KP191458/Lidar2d/README.md

# Lidar2d
Hardware and software implementation of two demensional lidar.
