KP191458/Lidar2d/Thesis/02_introduction.tex

\section {Wstęp}
\subsection {Czym jest LIDAR ?}

Za wikipedią:
Lidar (od angielskiego akronimu LIDAR, utworzonego od wyrażenia: Light Detection and Ranging)
– urządzenie działające na podobnej zasadzie jak radar (Radio Detection and Ranging), ale
wykorzystujące światło lasera zamiast mikrofal. Urządzenie charakteryzuje się wysoką
rozdzielczością \cite{lidar_pl}.\\

Pierwsze użycie lasera do pomiaru odległości miało miejsce na potrzeby amerykańskiego 
wojska na początku lat 60, zaraz po wynalezieniu lasera. Było to użycie laserowego dalmierza 
model Colidar Mark II - obiekt, ze względu na swoje rozmiary, przypominał strzelbę \cite{lidar_en}.\\

Pierwsze zastosowanie urządzeń przypominających obecne Lidary to rok 1971 i działalność
Amerykańskiego Centrum Badań Fizyki Atmosfery w Boulder w Kolorado (National Center for
Atmospheric Research). Urządzenie dokonywało pomiaru wysokości chmur i zanieczyszczenia
atmosferycznego. Kolejne zastosowanie tego samego roku miało miejsce w czasie misji
Apollo 15 gdzie za pomocą sonaru laserowego (tak technologia ta była wówczas nazywana)
skanowano powierzchnię księżyca \cite{lidar_en}.\\

Ogólna zasada działania polega na połączeniu lasera z teleskopem. Laser wysyła, poprzez układ optyczny, bardzo krótkie i dokładnie wymierzone, ale silne impulsy elektromagnetyczne w widmie światła widzialnego lub podczerwonego. Na przebytym dystansie światło to ulega rozproszeniu, które jest obserwowane za pomacą teleskopu, fotodiody, fotopowielacza albo kamer CCD lub CMOS. \\

Zasadę te doskonale ilustruje rysunek z książki Paula McManamoma:
Figure 1.2 LiDAR Conceptual diagram (adapted from Ref. 3) \cite{mcmanamom}.\\
\begin{figure}[h]
    \centering
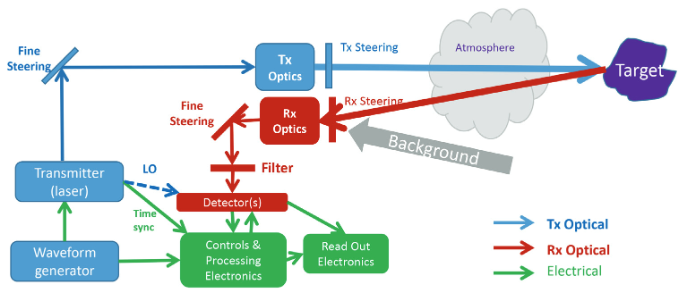
[picture p1: Thesis/images/lidar_concept.png]
    
    \caption{Rysunek z książki Paula McManamoma - LiDAR Conceptual diagram}
    \label{fig:lidar_concept}
\end{figure}

Dr. Pinliang Dong w swojej książce "LiDAR Remote Sensing and Applications" prezentuje wpływ zjawisk atmosferycznych na pomiary Lidaru \cite{dong}, jednak w mojej pracy pomiarów dokonywałem jedynie w pomieszczeniach zamkniętych (co z resztą sugerowała specyfikacja dalmierza TFmini Plus gdzie deklarowana przez producenta dokładność podana była dla pomieszczeń zamkniętych).\\

\subsection {Cel pracy}
Celem pracy jest zbudowanie działającej implementacji (zarówno sprzętowej jak i programowej) lidaru dwuwymiarowego za pomocą dalmierza laserowego oraz silnika krokowego. Te dwa urządzenia będą rdzeniem implementacji która za pośrednictwem mikrokontrolera będzie w stanie przekazać do komputera dane z których napisany przez nas program wygeneruje dwuwymiarowy obraz pomieszczenia.

\subsection {Współczesne zastosowanie lidarów}
Lidary mają dzisiaj szerokie zastosowanie: zarówno cywilne jak militarne. Technologia ta ma zastosowanie w architekturze, budownictwie, meteorologii, wywiadzie wojskowym i cywilnym, przemyśle produkcyjnym, na kolei czy w kartografii.\\

Pomimo że moja praca skupia się na podstawach działania i jest implementacją czysto amatorską, pragnąłbym przybliżyć nieco lepiej współczesne zastosowanie zaawansowanych technologicznie lidarów. Pozwoli to zrozumieć czemu technologia ta jest dziś tak ważna i dlaczego stanowi tak istotny element rozwoju wielu gałęzi gospodarki.\\

\subsubsection{Zastosowanie na kolei}
Ciekawym przypadkiem użycia lidarów jest zastosowanie przy inwentaryzacji i inspekcji torów kolejowym. Urządzenie skanujące umieszczone jest na frontowej części pociagu i dokonuje ciągłego skanowania zarówno torów, terenu jak i pozostałych elementów infrastruktury kolejowej (słupów, peronów, barierek a nawet całych stacji).\\

\begin{figure}[h]
    \centering
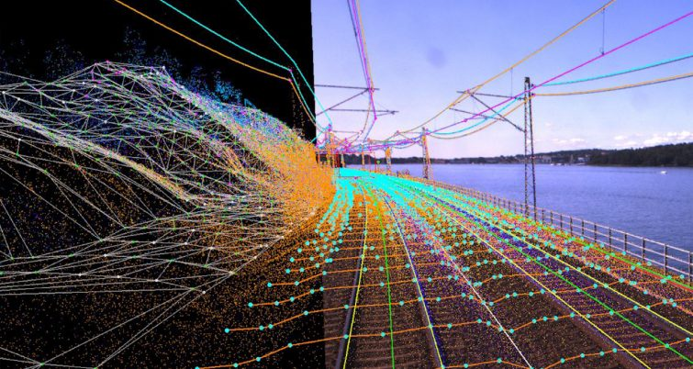
[picture p2: Thesis/images/LiDAR-AC-Image-1-755x402.jpg]
    
    \caption{Przykład skanu z artykułu: \cite{tory}}
    \label{fig:tory}
\end{figure}

Dzięki cyklicznym pomiarom i porównywaniu wyników system jest z stanie znaleźć nawet najdrobniejsze zmiany w terenie czy infrastrukturze. Pozwala to przewidzieć osiadanie terenu, odkształcenia torów czy uszkodzenia infrastruktury zanim jeszcze zmiany te okażą się krytyczne i staną się powodem usterek. Co więcej system jest w stanie przewidzieć np. optymalną prędkość (konfortową dla pasażerów) bądź uprzedać o istotnych niebezpiecznych zakrętach. System z powodzeniem stosowany w Wielkiej Brytanii, Francji czy Indiach.\\

Z laserowej inspekcji torów korzysta również nowojorskie metro.

\subsubsection{Zastosowanie w budownictwie}
Zastosowanie w budownictwie jest bardzo szerokie natomiast kilka ciekawych rozwiązań posiada w swojej ofercie firma Leica. Serię BLK nazwałbym kamieniami milowymi współczesnego rozwoju technologii Lidar.\\

\textbf{BLK360}

\begin{figure}[h]
    \centering
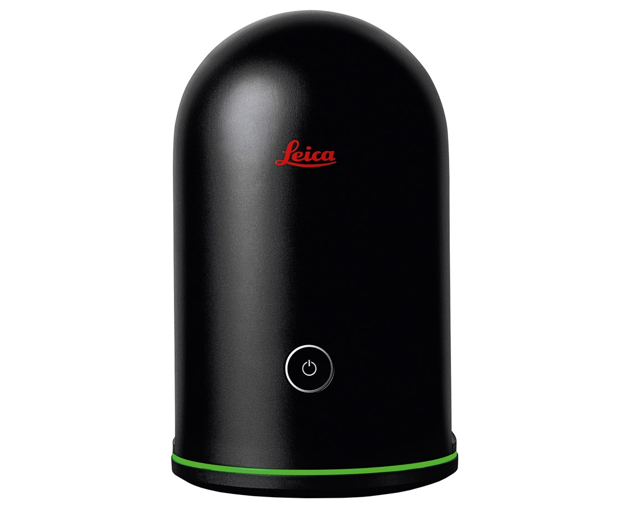
[picture p3: Thesis/images/Leica_BLK360_Front2.jpg]
    
    \caption{Frontowy panel urządzenia BLK360 \cite{blk360}}
    \label{fig:blk360}
\end{figure}

Urządzenie jest urządzniem statycznym. Zczytuje 360,000 punktów na sekundę z milimetrową dokładnością. Zasięg do 60 metrów. Dodatkowo rejestruje obraz z 3 kamer dzięki czemu możliwe jest również zastosowanie sztucznej inteligencji (głównie technologii \textbf{Uczenia Maszynowego}) do rozpoznawania obiektów w budynku (okna, drzwi, instalacje) i tworzenia interaktywnego modelu \textbf{BIM (Building Information Modeling)}.\\

\textbf{BLK2GO}

Mobilna i ulepszona wersja BLK360. Pozwala tworzyć modele całych budynków w czasie rzeczywistym. Dodatkowo również obsługuje rozpoznawanie elementów budynku i tworzy model BIM.\\
\begin{figure}[h]
    \centering
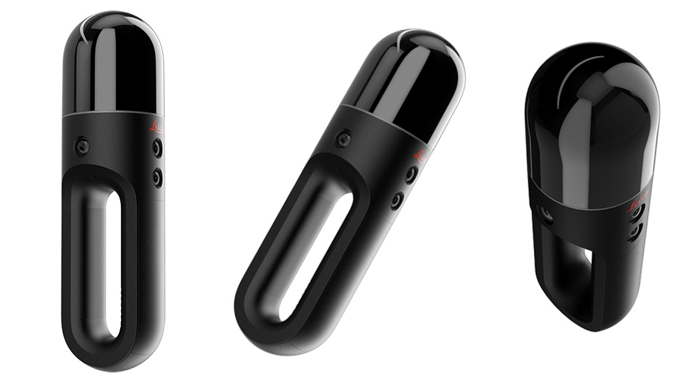
[picture p4: Thesis/images/blk2go.jpg]
    
    \caption{Frontowy panel urządzenia BLK2GO \cite{blk2go}}
    \label{fig:blk2go}
\end{figure}

\textbf{BLK2FLY}

\begin{figure}[h]
    \centering
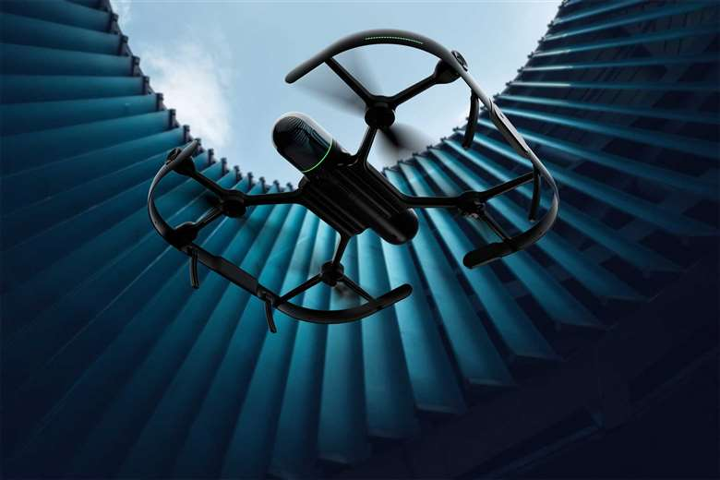
[picture p5: Thesis/images/BLK2FLY.jpg]
    
    \caption{Render planowanego wyglądu urządzenia BLK2FLY \cite{blk2fly}}
    \label{fig:blk2fly}
\end{figure}

We wrześniu 2021 roku pojawił się oficjalny komunikat firmy Leica dotyczący kolejnego projektu - \textbf{BLK2FLY}. Urządzenie wykorzystuje drona i jest w pełni autonomiczne. Użytkownik, na urządzeniu mobilnym, wybiera jedynie porządany obiekt (np. cały budynek) a automatycznie sterowany dron samodzielnie dokonuje wszystkich zadanych pomiarów. Ogromna mobilność drona pozwala na pomiar trudno dostępnych dla człowieka miejsc.\\

\textbf{BLK247}\\
System monitoringu przemysłowego który prócz technologii Lidar wykorzystuje jeszcze obraz wideo i pomiar temperatury powierzchni.\\
\begin{figure}[h]
    \centering
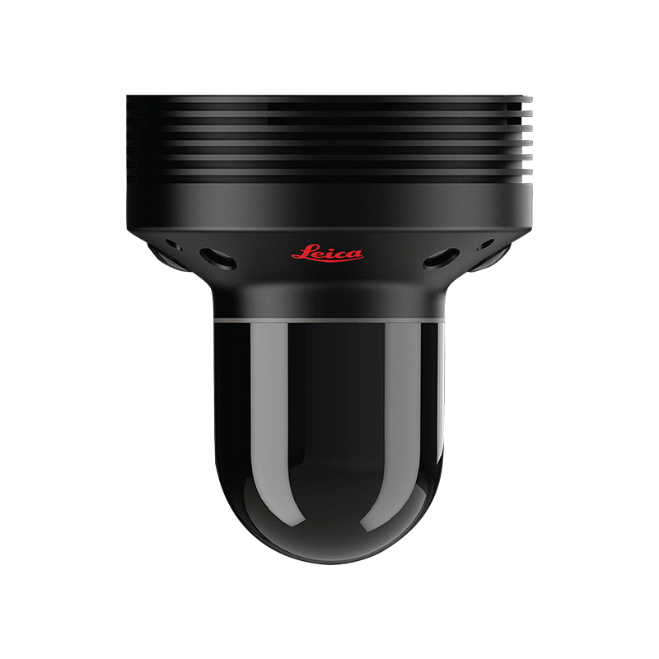
[picture p6: Thesis/images/BLK247.jpg]
    
    \caption{Pojedyncza kamera systemu BLK247 \cite{blk247}}
    \label{fig:blk247}
\end{figure}
Przewagę nad systemami monitoringu wykorzystującymi jedynie kamery jest taka że system jest w stanie tworzyć obraz i wykrywać ruch nawet przy całkowitej ciemności. Dodatkowo system termowizyjny wykrywa ludzi i zwierzęta a technologie AI pozwalają klasyfikować wykrywane obiekty.

\begin{figure}[h]
    \centering
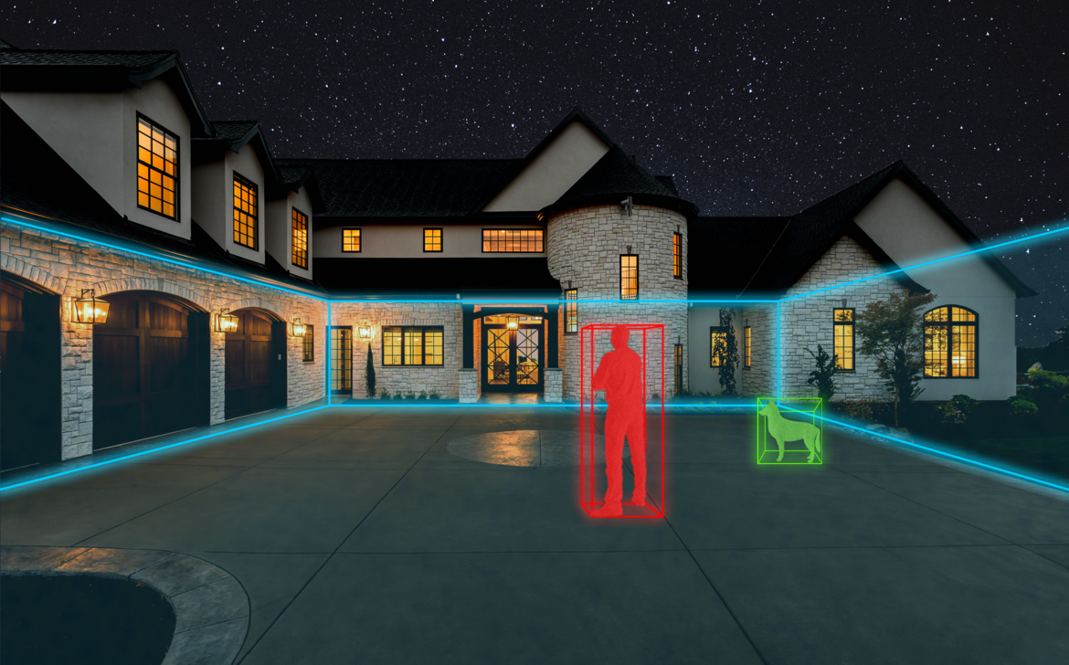
[picture p7: Thesis/images/BLK247-house-night_0.png]
    
    \caption{Poglądowy schemat działania ze strony internetowej producenta \cite{blk247}}
    \label{fig:house-night}
\end{figure}

\newpage
\subsubsection{Zastosowanie w kartografii}
Jednym z pierwszych zastosowań lidarów było zastosowanie ich w kartografii. Dziś jest to technologia używana zarówno przez wojskowe agencje wywiadowcze jak i korporacje jak Google czy Apple w swoich aplikacjach służących do nawigacji w terenie.\\

Rozróżniamy trzy podstawowe sposoby dokonywania pomiarów: lotniczy, mobilny i naziemny. Oba opisał dokładnie w swojej książce "Laser Scanning Systems in Highway and Safety Assessment" Biswajeet Pradhan \cite{pradhan}.\\

\textbf{Pomiar lotniczy}\\
Podstawą pomiaru lotniczego jest zarówno pomiar lidarowy jak i wykonanie wysokiej rozdzielczości zdjęć. Pozwala to nie tylko zbadać ukształtowanie terenu ale i odnieść pomiar do wykonanych zdjęć. Poniżej rysunek z książki Biswajeeta Pradhana

\begin{figure}[h]
    \centering
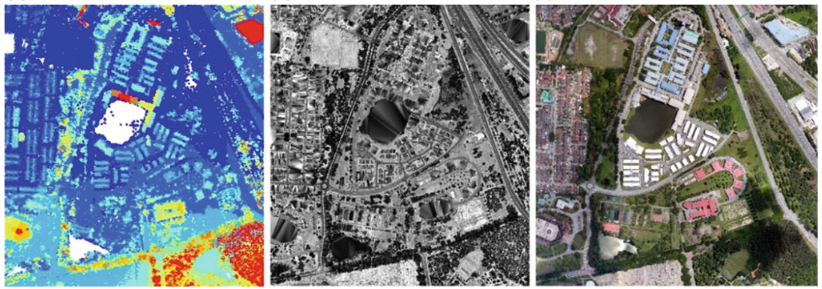
[picture p8: Thesis/images/lidar_lotniczy.png]
    
    \caption{Dane z lidaru lotniczego \cite{pradhan}}
    \label{fig:lidar_lotniczy}
\end{figure}
Te 3 zdjęcia to kolejno: pomiar z użyciem lidaru pokazujący w róznych kolorach wysokości względne mierzonych budynków, pomiar lidarowy gdzie odcieniami szarości przedstawione jest zagęszczenie obiektów, a trzecie to zdjęcie wysokiej rozdzielczości.\\

\textbf{Pomiar mobilny}\\
Jest obecnie bardzo powszechną metodą pomiarów. Lidar (wraz z systemem GPS, IMU i kamerami) dokonuje pomiarów z poziomu jeżdzącego ulicami pojazdu. Prócz trajektorii ulic lidar dokonuje jeszcze pomiaru budynków. Umożliwia to póżniejsze stworzenie trójwymiarowych map znanym m.in. z usługi Google Maps Street View (obecnie również w Apple Maps dla wybranych miast).\\

Korzyścią takiego rodzaju pomiaru, w stosunku do pomiaru lotniczego, jest możliwość uchwycenia budynków z różnych jego stron. Pozwala to na stworzenie pełniejszego jego obrazu w trzech wymiarach. Wadą jest fakt że pomiarów dokonamy jedynie z wysokości poziomu drogi.\\

\begin{figure}[h]
    \centering
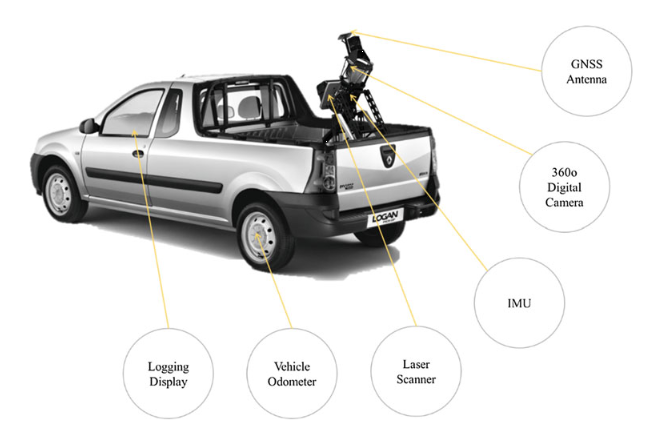
[picture p9: Thesis/images/lidar_mobilny.png]
    
    \caption{Schemat urządzenia mobilnego z ksiażki B.Pradhana \cite{pradhan}}
    \label{fig:lidar_mobilny}
\end{figure}

\newpage
\textbf{Pomiar naziemny}\\
Stosowany jest w najczęściej w przypadku budynków. Lidar dokonuje wtedy bardzo dokładnego pomiaru stojąc statycznie w miejscu. Zaletą jest duża dokładność, możliwość wyboru zakresu analizy (patrz rysunek \ref{fig:lidar_naziemny}) oraz mozliwość zastosowania go w czasie rzeczywistym, rozpoznawania obiektów (w przypadku pomiaru mobilnego często odbywa się on na bazie już pomierzonych danych a nie w trakcie pomiarów).\\

\begin{figure}[h]
    \centering
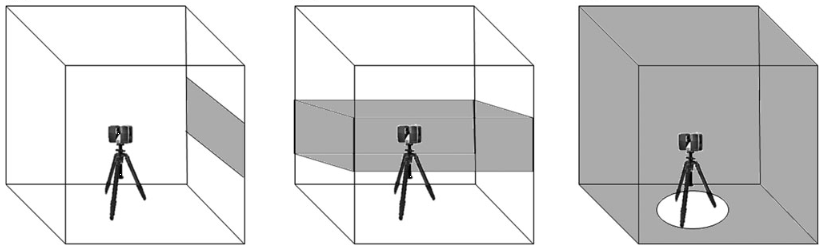
[picture p10: Thesis/images/lidar_naziemny.png]
    
    \caption{Przykłady sposobu pomiaru naziemnego z ksiażki B.Pradhana \cite{pradhan}}
    \label{fig:lidar_naziemny}
\end{figure}

\textbf{Podsumowanie pomiarów kartograficznych}\\
Każda z wymienionych wyżej metod ma swoje wady i zalety. Począwszy od kosztów (najdroższy lotniczy - najtańszy naziemny), przez zastosowanie (lotniczy to pomiar w wysokości - pozostałe tylko z poziomu powierzchni), gęstość pomiarów (lotniczy ma najniższą - naziemny i mobilny znacznie wyższą) czy szybkość dokonywanych pomiarów (lotniczy najszybszy - naziemny najwolniejszy). Wybór metody dyktują nam posiadane środki bądź charakter naszych pomiarów.

\newpage
\subsubsection{Zastosowanie militarne}
Powszechnie znane jest również militarne zastosowanie lidarów. Prócz systemów rozpoznania ciekawymi zastosowaniami są n. wykrywanie min czy wizualizowanie zadrzewionego obszaru \cite{military}. Dodatkowo zaletą jest że lidary są obecnie niewielkich rozmiarów co pozwala wysyłać zarówno pojazdy bez załogowe czy drony  na tereny zagrożone i mogą one z powodzeniem tworzyć obraz otoczenia nawet w całkowitej ciemnośći.\\

\subsubsection{Zastosowanie w geotechnice}
Ze względu na statyczny charakter powierzchni geologicznych - skał, masywów ziemnych, jaskiń - lidar jest idealnym urządzeniem do tworzenia bardzo dokładnych map (zarówno dwu- jak i trójwymiarowych). Duża dokładność pomiarów pozwala rozpoznać fakturę skał czy np. wykryć powierzchnię wody. Dzięki przetwarzaniu obrazu wszystko to może zostać przedstawione w sposób czytelny dla człowieka. Poniżej kilka przykładów z ksiażki Dr. Donga \cite{dong}\\

\begin{figure}[h]
    \centering
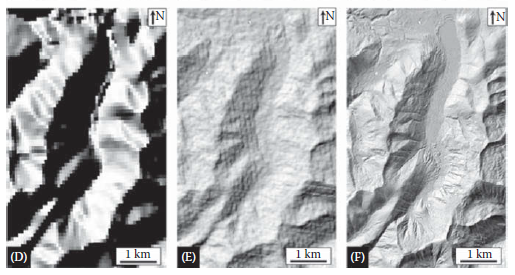
[picture p11: Thesis/images/dong_1.png]
    
    \caption{Przykłady dokładności w zależności od rozdzielczości lidaru \cite{dong}}
    \label{fig:dong_1}
\end{figure}

\begin{figure}
    \centering
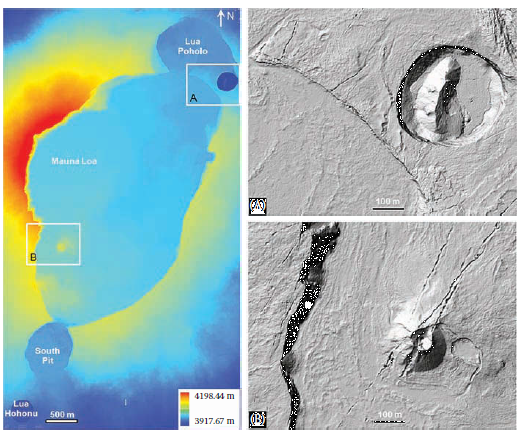
[picture p12: Thesis/images/dong_2.png]
    
    \caption{Przykłady szczegółowego odwzorowania terenu \cite{dong}}
    \label{fig:dong_2}
\end{figure}

\begin{figure}
    \centering
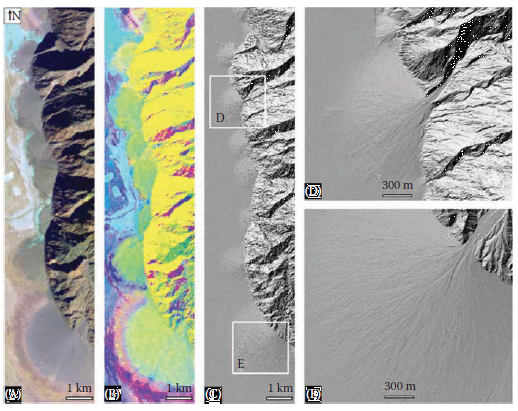
[picture p13: Thesis/images/dong_3.png]
    
    \caption{Przykłady wyraźnie zarysowanej powierzchni wody \cite{dong}}
    \label{fig:dong_3}
\end{figure}

\newpage
\newpage
\subsubsection{Podsumowanie zastosowań}
Pomimo że moja praca ma czysto amatorski charakter i zajmuje się jedynie odtworzeniem podstaw działania techniki lidarowej, uważam że jest to bardzo istotna gałąź technologiczna.\\

Sam fakt zastosowania w tak wielu dziedzinach jak architektura, transport, wywiad wojskowy, przemysł czy kartografia czyni z tej technologii istotny element konkurencji technologicznej.
