KP191458/Lidar2d/Thesis/thesis.tex

\documentclass{thesis}
\usepackage{graphicx}
\graphicspath{ {./images/} }
\usepackage{color}
\usepackage{listings}
\usepackage{xcolor}

\definecolor{codegreen}{rgb}{0,0.6,0}
\definecolor{codegray}{rgb}{0.5,0.5,0.5}
\definecolor{codepurple}{rgb}{0.58,0,0.82}
\definecolor{backcolour}{rgb}{0.95,0.95,0.92}

\lstdefinestyle{codestyle}{
    backgroundcolor=\color{backcolour},   
    commentstyle=\color{codegreen},
    keywordstyle=\color{magenta},
    numberstyle=\tiny\color{codegray},
    stringstyle=\color{codepurple},
    basicstyle=\ttfamily\footnotesize,
    breakatwhitespace=false,         
    breaklines=true,                 
    captionpos=b,                    
    keepspaces=true,                 
    numbers=left,                    
    numbersep=5pt,                  
    showspaces=false,                
    showstringspaces=false,
    showtabs=false,                  
    tabsize=2
}

\lstset{style=codestyle}

\begin{document}
\include{01_titlepage}
\newpage
\tableofcontents
\newpage

\include{02_introduction}
\include{03_how_it_works}
\include{04_hardware}
\include{05_software}
\include{06_experiments}
\include{07_problems}
\include{08_conclusions}

\begin{thebibliography}{10}
\bibitem{lidar_pl} \url{https://pl.wikipedia.org/wiki/Lidar}
\bibitem{lidar_en} \url{https://en.wikipedia.org/wiki/Lidar}
\bibitem{mcmanamom} Paul McManamom "LiDAR Technologies and Systems" 2019
\bibitem{dong} Dr. Pinliang Dong, Qi Chen "LiDAR Remote Sensing and Applications", CRC Press, 2018
\bibitem{microstepping} \url{https://hackaday.com/2016/08/29/how-accurate-is-microstepping-really/}
\bibitem{arduino} \url{https://pl.wikipedia.org/wiki/Arduino}
\bibitem{helios} \url{https://www.mgprojekt.com.pl/helios}
\bibitem{arduino_lic} \url{https://github.com/arduino/Arduino/blob/master/license.txt}
\bibitem{accelstepper_lic} \url{https://www.airspayce.com/mikem/arduino/AccelStepper/}
\bibitem{tfmini_lic} \url{https://github.com/opensensinglab/tfmini}
\bibitem{python_lic} \url{https://docs.python.org/3/license.html}
\bibitem{pyqt5_lic} \url{https://pypi.org/project/PyQt5/}
\bibitem{pyqtgraph_lic} \url{https://www.pyqtgraph.org/}
\bibitem{tory} \url{https://www.rtands.com/passenger/lidar-a-tool-for-the-virtual-world/}
\bibitem{blk360} \url{https://shop.leica-geosystems.com/learn/reality-capture/blk360}
\bibitem{blk2go} \url{https://shop.leica-geosystems.com/learn/reality-capture/blk2go-overview}
\bibitem{blk2fly} \url{https://blk2021.com/blk2fly/}
\bibitem{blk247} \url{https://shop.leica-geosystems.com/learn/reality-capture/blk247}
\bibitem{pradhan} Biswajeet Pradhan "Laser Scanning Systems in Highway and Safety Assessment", Springer, 2020
\bibitem{military} \url{https://idstch.com/technology/photonics/military-applications-lidar/}

\end{thebibliography}
\newpage
\listoffigures
\end{document}
