KP191458/Lidar2d/Thesis/01_titlepage.tex

\pretitle{Inżynierska praca dyplomowa}
\title{Realizacja sprzętowa i programowa lidaru dwuwymiarowego}
\svnurl{https://github.com/KP191458/Lidar2d}
\author{Konrad Pławik}
\department{Wydział Fizyki Technicznej, Informatyki \par i Matematyki Stosowanej}
\promotor{dr inż. Krzysztof Lichy}
\examdate{Wrzesień 2021}
\maketitle
