KP191458/Lidar2d/Thesis/images/ftims.png

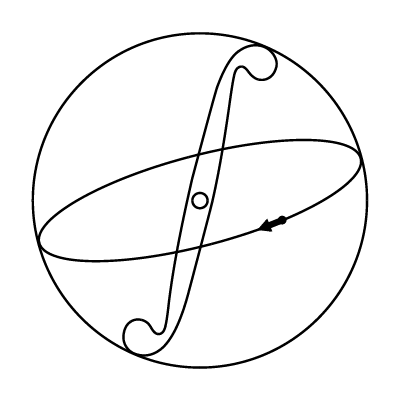
Thesis/images/ftims.png
