KP191458/Lidar2d/Thesis/06_experiments.tex

\section {Eksperymenty}
\subsection {Eksperyment pierwszy: pomieszczenie codziennego użytku}
Pierwszy z wykonanych eksperymentów polegał na wygenerowaniu obrazu pomieszczenia w którym pracowałem nad pisaną właśnie pracą dyplomową (salon z aneksem kuchennym).
Pomieszczenie ma 19.1 metra kwadratowego i znajdują się w nim elementy codziennego użytku - lodówka, zlew kuchenny, kwiaty na parapecie oraz otwór drzwiowy łączący pomieszczenie z przedpokojem. Wymiary pokoju to 3.60 m x 5.30 m.\\

Poniższy rysunek przedstawia architektoniczny rzut pomieszczenia wykonany przez mgr arch. Izabelę Jaroszek (fragment zakupionej w czasie remontu adaptacji wnętrza):
\begin{figure}[h]
    \centering
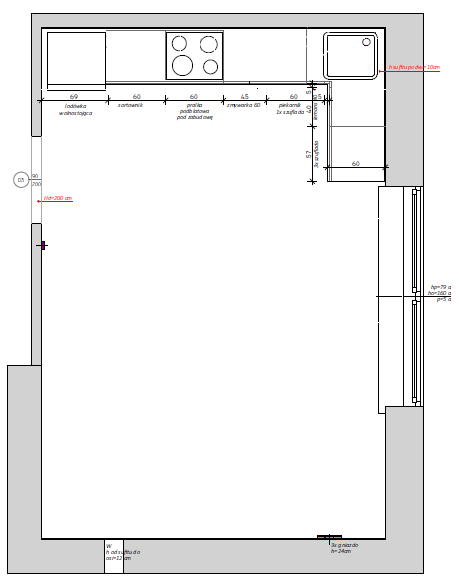
[picture p27: Thesis/images/experiment_1_rzut.png]
    
    \caption{Rzut architektoniczny salonu z aneksem kuchennym}
    \label{fig:experiment_1_rzut}
\end{figure}

Dla opisanego pomieszczenia wygenerowany został następujący obraz:
\begin{figure}[h]
    \centering
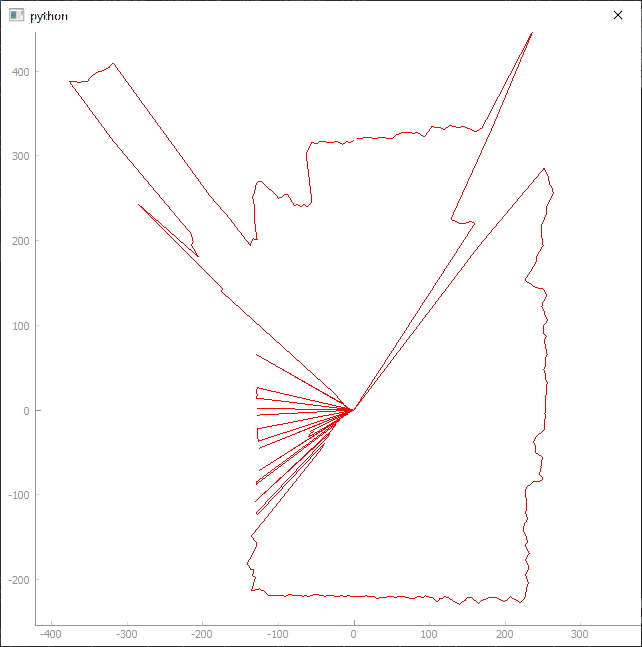
[picture p28: Thesis/images/experiment_1_plot.png]
    
    \caption{Wygenerowany obraz pomieszczenia - salonu z aneksem kuchennym}
    \label{fig:experiment_1_plot}
\end{figure}

W chwili generowania obrazu dalmierz znajdował się ok. 110 cm ponad powierzchnią podłogi, dzięki czemu nie znalazły się na nim stojące w pokoju przedmioty i umeblowanie.

\subsection {Eksperyment pierwszy: analiza wygenerowanego obrazu}

Wygenerowany obraz przedstawia dosyć wierne odwzorowanie badanego pomieszczenia. Ze względu na amatorski charakter urządzenia znalazło się w nim jednak kilka przekłamań:

\begin{enumerate}
    \item Otwór drzwiowy spowodował odczyt odległości do ściany w sąsiednim pomieszczeniu (przedpokoju) oraz kolejnym pokoju.
    \item Połyskująca powierzchnia lodówki wprowadziła przekłamanie na jej frontowej powierzchni - wygenerowany jej obraz sprawia mylne wrażenie rombu. 
    \item Metalowy kran o obłym krztałcie wprowadza kilka znieszkałceń - ze względu na refleksję promienia lasera.
    \item Na parapecie stoją doniczki z kwiatami co uwzględnione zostało na nieregularnych kształtach wykresu
    \item Puste ściany i kąty proste odzwierciedlone zostały z dosyć dużą dokładnością.
    \item Ściana na przeciw okna została odzwierciedlona z kilkoma przekłananiami (odczyty zerowych wartości dalmierza). Powierzchnia w tym miejscu nie różni się niczym od pozostałch powierzni, zarówno użytą farbą, kolorem jak i nasłonecznieniem. Przyczyna błędnych wskazań w tym miejscu pozostaje nieznana.
    \item Wymiary pomieszczenia odzwierciedlają stan faktyczny.
\end{enumerate}
\begin{figure}[h]
    \centering
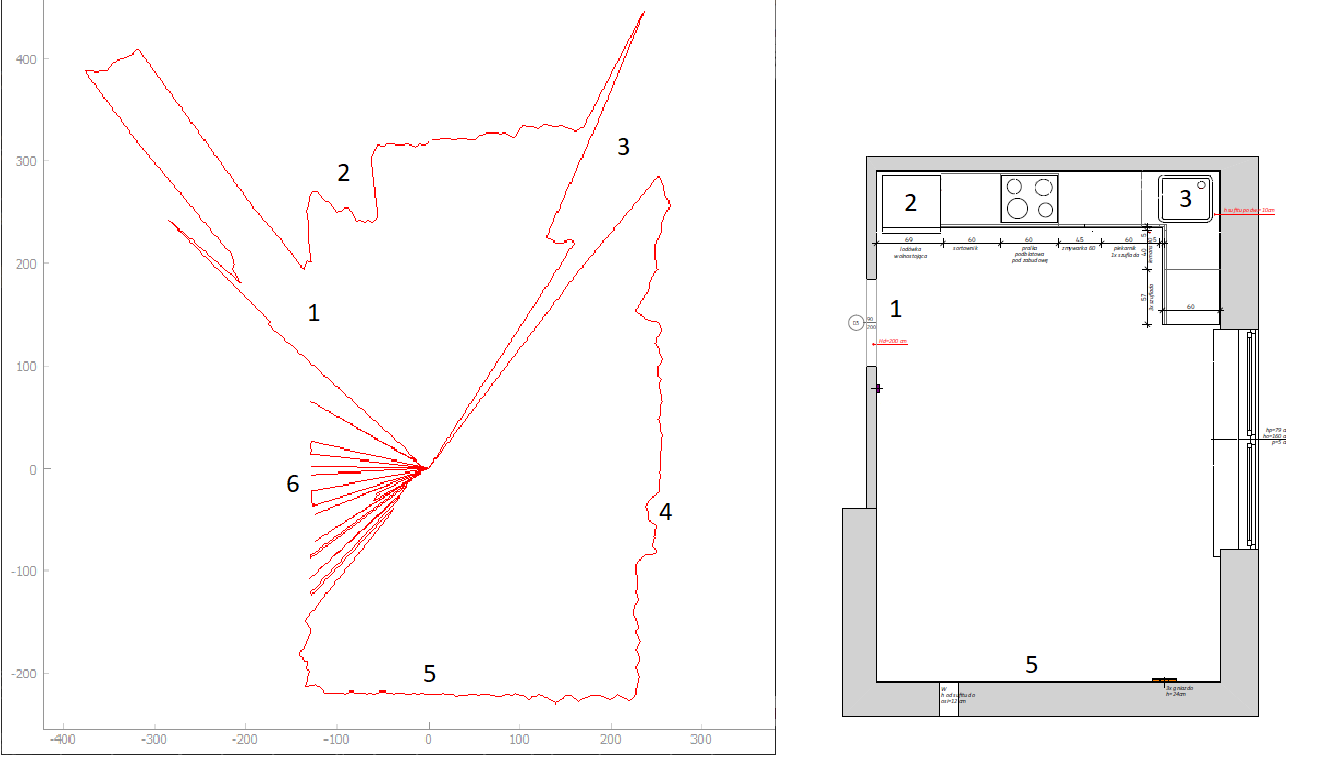
[picture p29: Thesis/images/experiment_1_comp.png]
    
    \caption{Porównanie obrazu z rzutem}
    \label{fig:experiment_1_comp}
\end{figure}

\newpage
\subsection {Eksperyment drugi: ocena użytej rozdzielczości}

W drugim eksperymencie chciałem przekonać się o dokładności dalmierza i o tym czy zastosowana przeze mnie rodzielczość (400 króków na pełen obrót) jest wystarczająca.\\

W tym celu wyłączyłem zasilanie silnika krokowego, przez co dalmierz zczytywał wciąż tę samą ogległość. Program jednak nadawał sygnał do zmiany kąta przez co przekonany był o obrocie silnika. W skutek tego otrzymaliśmy obraz okręgu (ta sama odległość dla "każdego" z kątów).

\begin{figure}[h]
    \centering
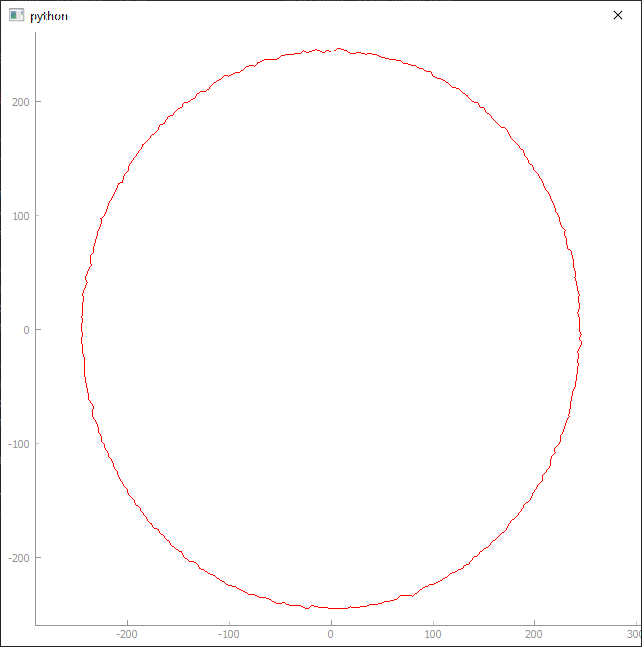
[picture p30: Thesis/images/experiment_2_plot.png]
    
    \caption{“Time is a flat circle” Friedrich Nietzsche}
    \label{fig:experiment_2_plot}
\end{figure}

\subsection {Eksperyment drugi: analiza wygenerowanego obrazu}
Wahania odczytów dalmierza różniły się od siebie z reguły o 1-2 cm, czasem o 3 cm. Wartość ta mieści się w podawanym w specyfikacji producenta zakresie.\\

Ilość wygenerowanych punktów (400) pozwoliła odwzorować okrąg z bardzo dużą dokładnością. Krzywizna okręgu jest gładka a jej krztałt nie jest sprawia wrażenia widocznych pixeli (prostych linii wynikających ze zbyt rzadkiej siatki punktów). Nie ma potrzeby zwiększania rozdzielczości pracy urządzenia.\\

\newpage
\subsection {Eksperyment trzeci: pomieszczenie z licznymi płaszczyznami}
Pomieszczenie do kolejnego eksperymentu wybrane zostało ze względu na duże rozmary i liczne płaszczyzny o różnym rodzaju powierzchni (firanki, ekran telewizora, okna, lodówka, połyskująca poręcz, granitowe schody). Poniższy rzut ze strony projektanta budynku - firmy MG Projekt \cite{helios}\\
\begin{figure}[h]
    \centering
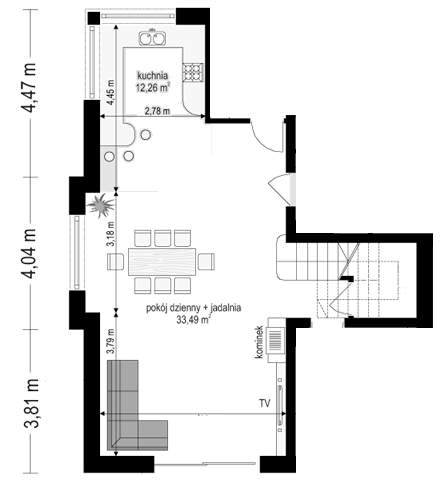
[picture p31: Thesis/images/experiment_3_rzut.png]
    
    \caption{Rzut architektoniczny pomieszczenia o skomplikowanym kształcie}
    \label{fig:experiment_3_rzut}
\end{figure}

Urządzenie pomiarowe ustawione zastało na wyspie kuchennej znajdującej się w przestrzeni pomiędzy częścią kuchenną a salonową na wysokości ok. 130 cm od powierzchni podłogi. Pozwoliło to uniknąć odwzorowania na obrazie elementów wyposażenia jak stół kuchenny, pufy czy taborety.\\
\begin{figure}[h]
    \centering
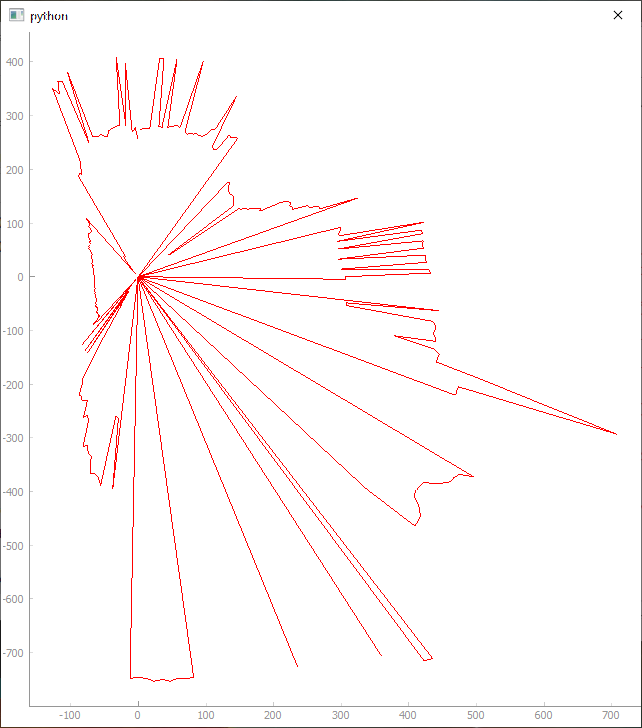
[picture p32: Thesis/images/experiment_3_plot.png]
    
    \caption{Wygenerowany obraz pomieszczenia o skomplikowanym kształcie}
    \label{fig:experiment_3_plot}
\end{figure}

\newpage
\subsection {Eksperyment trzeci: analiza wygenerowanego obrazu}
Wygenerowany obraz zawierał zarówno liczne drobne przekłamania jak i elementy odwzorowane z dużą dokładnością:\\
\begin{figure}[h]
    \centering
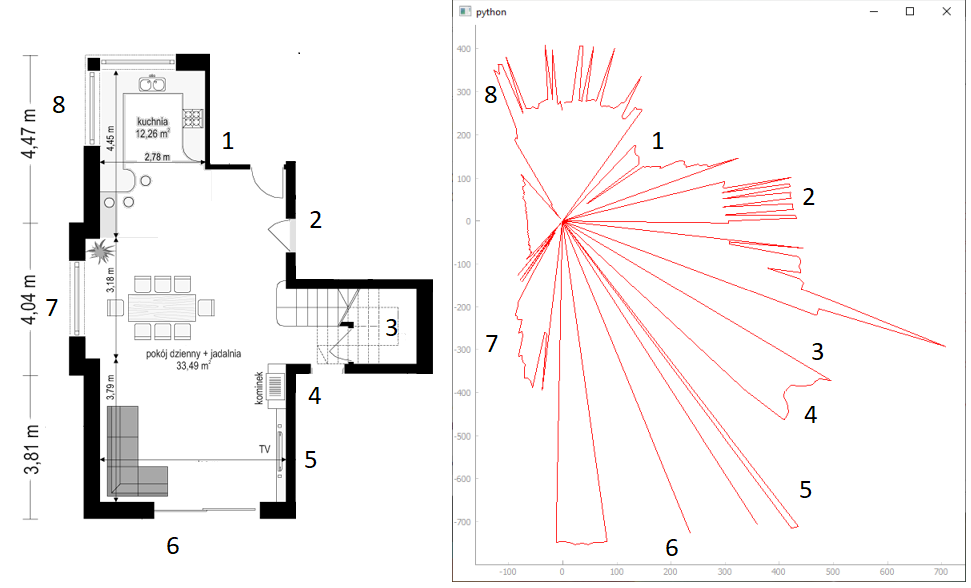
[picture p33: Thesis/images/experiment_3_comp.png]
    
    \caption{Porównanie obrazu z rzutem}
    \label{fig:experiment_3_comp}
\end{figure}

\begin{enumerate}
    \item Połyskująca powierzchnia lodówki - sporo odczytów zerowych.
    \item Drzwi łazienkowe wykończone były przyciemnianym szkłem.
    \item Klatka schodowa była widoczna na zarysie ale szczegóły były trudne do odczytania.
    \item Róg o matowej powierzchni odwzorował się dokładnie.
    \item Znajdujący się na ścianie telewizor nie został odwzorowany zupełnie. Same odczyty zerowe na jego powierzchni.
    \item Brak żaluzji w oknach salonu i widok na otwartą nasłonecznioną powierzchnie również praktycznie nie był widoczny na obrazie.
    \item Falista powierzchnia firanek została odwzorowana.
    \item Brak żaluzji w oknach kuchennych skutkował nierównomierną powierzchnią obrazu (duże wahania mierzonej odległości)
    \item Liczne zerowe odczyty na pozostałych powierzchniach. Pogarszały one obraz ale nie uniemożliwiały rozpoznania kształtu pomieszczenia.
\end{enumerate}

\newpage
\subsection {Eksperyment czwarty: pomieszczenie o prostym kształcie}
Pomieszczenie do eksperymentu zostało wybrane ze względu na dużą ilość powierzchni płaskich, kąty proste, żaluzje okienne i relatywnie prosty kształt.\\
\begin{figure}[h]
    \centering
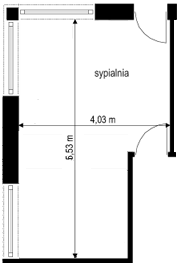
[picture p34: Thesis/images/experiment_4_rzut.png]
    
    \caption{Rzut architektoniczny pomieszczenia o prostym kształcie}
    \label{fig:experiment_4_rzut}
\end{figure}

Wygenerowany obraz był zaskakująco wiernym odzwierciedleniem badanego pomieszczenia:
\begin{figure}[h]
    \centering
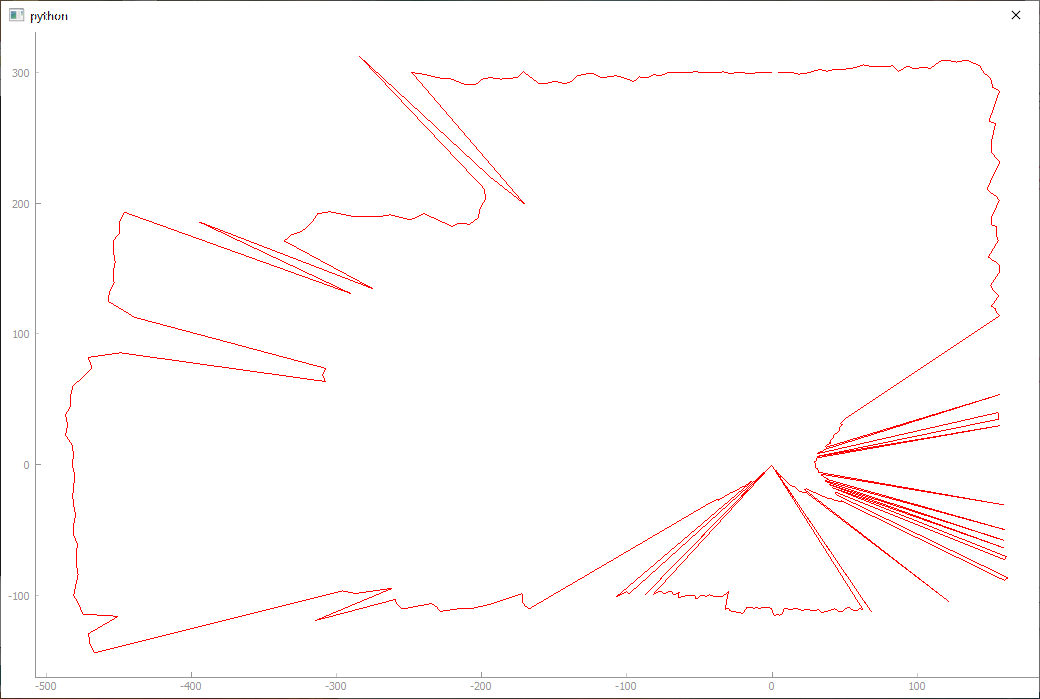
[picture p35: Thesis/images/experiment_4_plot.png]
    
    \caption{Wygenerowany obraz pomieszczenia o prostym kształcie}
    \label{fig:experiment_4_plot}
\end{figure}

\newpage
\subsection {Eksperyment czwarty: analiza wygenerowanego obrazu}
W czasie generowania obrazu urządzenie zostało umieszczone ok. 2 metrów ponad powierzchnią podłogi. Pomimo że wygenerowany obraz był zaskakująco wiernym odzwierciedleniem badanego pomieszczenia, znalazły się w nim nieliczne przekłamania.
\begin{figure}[h]
    \centering
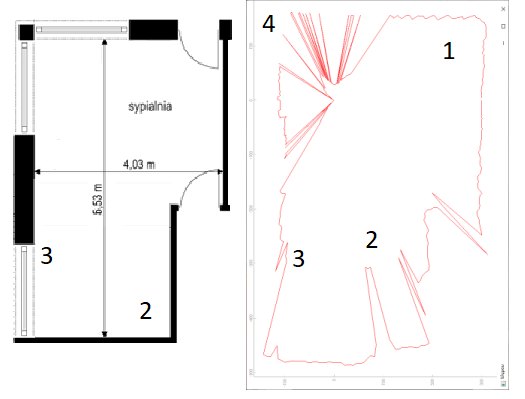
[picture p36: Thesis/images/experiment_4_comp.png]
    
    \caption{Porównanie obrazu z rzutem}
    \label{fig:experiment_4_comp}
\end{figure}
\newpage
\begin{enumerate}
    \item Zarówno gładkie płaszczyzny ścian i kąty proste zostały odwzorowane poprawnie z dużą dokładnością.
    \item Zakłócenia spowodowane dwiema lampami znajdującymi się w tej części pokoju.
    \item Wnęki okienne były widoczne na wygenerowanym obrazie.
    \item Powtórzył się problem zerowych odczytów dla niewielkich kątów dla ścian w bliskiej odległości.
    \item Żaluzje okienne umożliwiły rozwiązanie problemu odwzorowania okien.
    \item Prócz tych wymienionych w punkcie czwartym zerowe odczyty praktycznie nie wystąpiły.
\end{enumerate}
