KP191458/Lidar2d/ReadAndRotate/ReadAndRotate.ino

/* 
  This program is the interpretation routine of standard output protocol of TFmini-Plus product on Arduino.
  For details, refer to Product Specifications.
  For Arduino boards with only one serial port like UNO board, the function of software visual serial port is to be used. 
*/ 

// Include the AccelStepper Library
#include <AccelStepper.h>

// Define pin connections
const int dirPin = 4;
const int stepPin = 5;

// Define motor interface type
#define motorInterfaceType 1

// Creates an instance
AccelStepper myStepper(motorInterfaceType, stepPin, dirPin);


#include <SoftwareSerial.h>  //header file of software serial port
SoftwareSerial Serial1(2,3); //define software serial port name as Serial1 and define pin2 as RX and pin3 as TX
/* For Arduinoboards with multiple serial ports like DUEboard, interpret above two pieces of code and directly use Serial1 serial port*/
int step = 0;
int dir = 0;

int dist; //actual distance measurements of LiDAR
int strength; //signal strength of LiDAR
float temprature;
int check;  //save check value
int i;
int uart[9];  //save data measured by LiDAR
const int HEADER=0x59;  //frame header of data package
void setup() {
  Serial.begin(9600); //set bit rate of serial port connecting Arduino with computer
  Serial1.begin(115200);  //set bit rate of serial port connecting LiDAR with Arduino
    myStepper.setMaxSpeed(1000);
  myStepper.setAcceleration(50);
  myStepper.setSpeed(100);
  myStepper.moveTo(0);
}
void loop() { 
  if (Serial1.available()) {  //check if serial port has data input
    if(Serial1.read() == HEADER) {  //assess data package frame header 0x59
      uart[0]=HEADER;
      if (Serial1.read() == HEADER) { //assess data package frame header 0x59
        uart[1] = HEADER;
        for (i = 2; i < 9; i++) { //save data in array
          uart[i] = Serial1.read();
        }
        check = uart[0] + uart[1] + uart[2] + uart[3] + uart[4] + uart[5] + uart[6] + uart[7];
        if (uart[8] == (check & 0xff)){ //verify the received data as per protocol
          dist = uart[2] + uart[3] * 256;     //calculate distance value
          strength = uart[4] + uart[5] * 256; //calculate signal strength value
          temprature = uart[6] + uart[7] *256;//calculate chip temprature
          temprature = temprature/8 - 256;
          Serial.print(step);
          Serial.print(" ");
          Serial.print("dist = ");
          Serial.print(dist); //output measure distance value of LiDAR
          Serial.print('\t');
          Serial.print("strength = ");
          Serial.print(strength); //output signal strength value
          Serial.print("\t Chip Temprature = ");
          Serial.print(temprature);
          Serial.println(" celcius degree"); //output chip temperature of Lidar
          take_step();
          
        }

      }

    }
  }
}

void take_step(){
  if(dir==0)
  {
    step++;
  }
  else
  {
    step--;
  }

  if(step==0)
  {
    dir=0;
  }
  if(step==400)
  {
    dir=1;
  }

  myStepper.moveTo(step);
  delay(100);
  myStepper.run();
}
