KP191458/Lidar2d/(commit log)

2021-02-21 Beginnning of thesis part, simple Arduino sheets for Lidar reading and simple python script for plots.
2021-06-17 Vertical flip of the plot.
    [BasicPlot.py]
2021-06-22 Scheme of the whole device. Problems described.
2021-09-08 Photos of device added.
2021-09-08 Photos of the driver added.
2021-09-09 Rails added. BLK series added.
2021-09-09 Added details of some advanced lidars and its usage.
